JAbstractClass/parcours1-giga/Parcours1/Typen.h

#pragma once
// Strukturen in eigenem Header, damit die automatischen Arduino-Prototypen sie kennen.

struct Stellmotor {
  int pinA, pinB;
  const char* name;
  bool stellung1;
  unsigned long start;
  bool aktiv;
};

// Taster: Ruhezustand wird beim Start gemessen, gedrueckt = Abweichung davon
// (funktioniert fuer Schalten nach GND und nach 3,3 V)
struct Taster {
  int pin;
  bool ruhe;             // Pegel im losgelassenen Zustand
  bool zustand;          // entprellter Pegel
  bool roh;
  unsigned long seit;
};
