JAbstractClass/parcours1-giga/Parcours1/arduino_secrets.example.h

#pragma once
// Vorlage: nach arduino_secrets.h kopieren und ausfuellen.

// true  = Giga spannt eigenes WLAN auf (Access Point)
// false = Giga verbindet sich mit einem vorhandenen WLAN (WPA2 mit Passwort, z. B. Handy-Hotspot)
#define WLAN_EIGENES_NETZ true

#define AP_SSID "Parcours1"
#define AP_PASS "mindestens8zeichen"

#define WLAN_SSID ""
#define WLAN_PASS ""
