JAbstractClass/parcours1-giga/(commit log)

2026-11-09 Parcours 1: Steuerung, Weboberflaeche und Auto-Update von GitHub
2026-11-09 HTTPS mit eigenem Zertifikat, NTP-Zeit, neues Dashboard
    - GitHub Pages scheiterte mit -3011: Zertifikatsliste auf dem Board taugt nicht,
    ISRG Root X1 wird jetzt direkt mitgegeben (Versionsabfrage und OTA-Download)
    - Uhrzeit per NTP fuer die Zertifikatspruefung
    - neues Dashboard (dashboard.html) mit Live-Schema, Kennzahlen, Aktivitaet
    - Vorschau-Server ohne Giga: tools/dashboard_preview.py
2026-11-09 README: Befehle g und u
2026-11-09 Dashboard: 3D-Kugelbahn mit three.js, Scroll-Kamerafahrt, helle Seite
    - Bahn als 3D-Szene: Stahlkugeln folgen echtem Zustand, stauen an der Stoppstelle
    - Kamerafahrt beim Scrollen durch alle Stationen, Teile anklickbar
    - Ereignis-Ringe, LEDs als farbige Lichtquellen
    - three.js kommt vom CDN; ohne Internet bleibt die Steuerung nutzbar
2026-11-09 Dashboard: 3D-Nachbau von Parcours 1 nach Bauanleitung
    - Turm, Anbau, Rahmen, Statik-Traeger mit roten Verbindern, X-Streben
    - gruene Flexschienen mit Sprossen, echter Looping, schwarz-weisse Spiralroehre
    - Wege nach S. 48/49: Stoppstelle, Loopingweiche (Stellweiche),
    Wechselweiche (Weichenhebel), Ruecklauf zum Kettenaufzug
    - Aufbau-Intro, Bloom, LEDs oben auf dem Turm
